zcheng0319-dot/Muscle-Activation-Monitor/website/assets/3030885b3bf76a7612c291005020146e.jpg

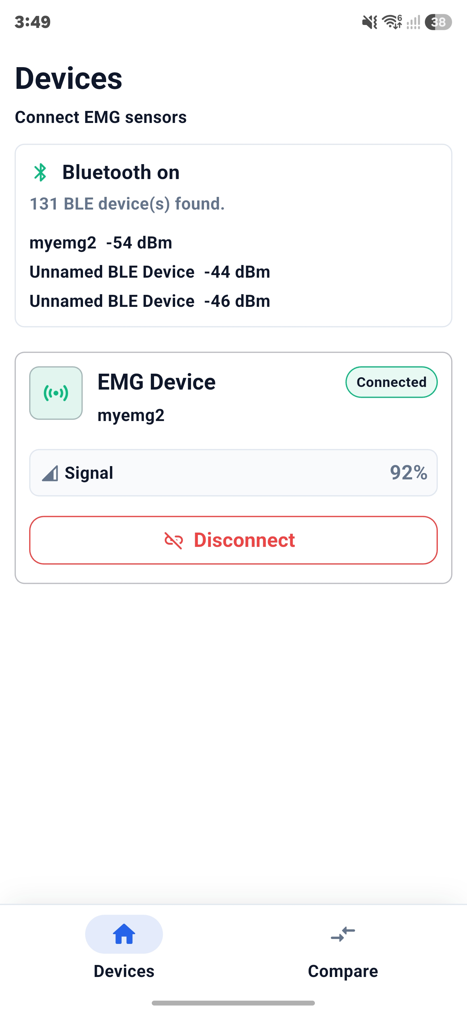
website/assets/3030885b3bf76a7612c291005020146e.jpg
