zcheng0319-dot/Muscle-Activation-Monitor/website/assets/device-1.png

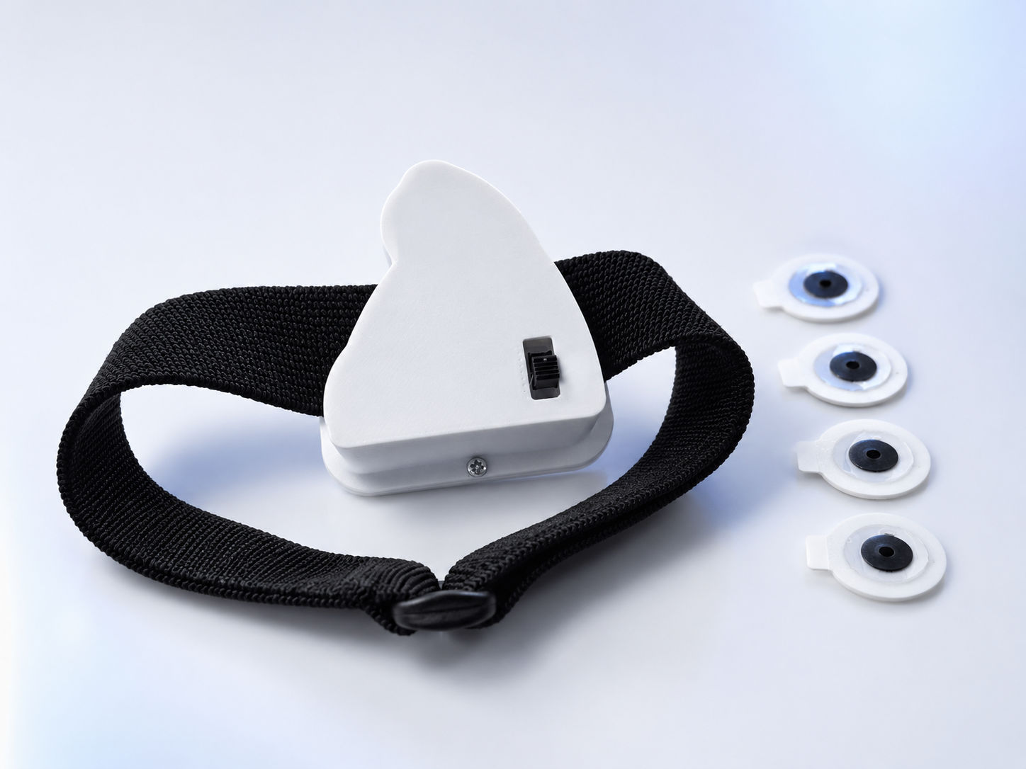
website/assets/device-1.png
