zcheng0319-dot/Muscle-Activation-Monitor/website/assets/device-2.png

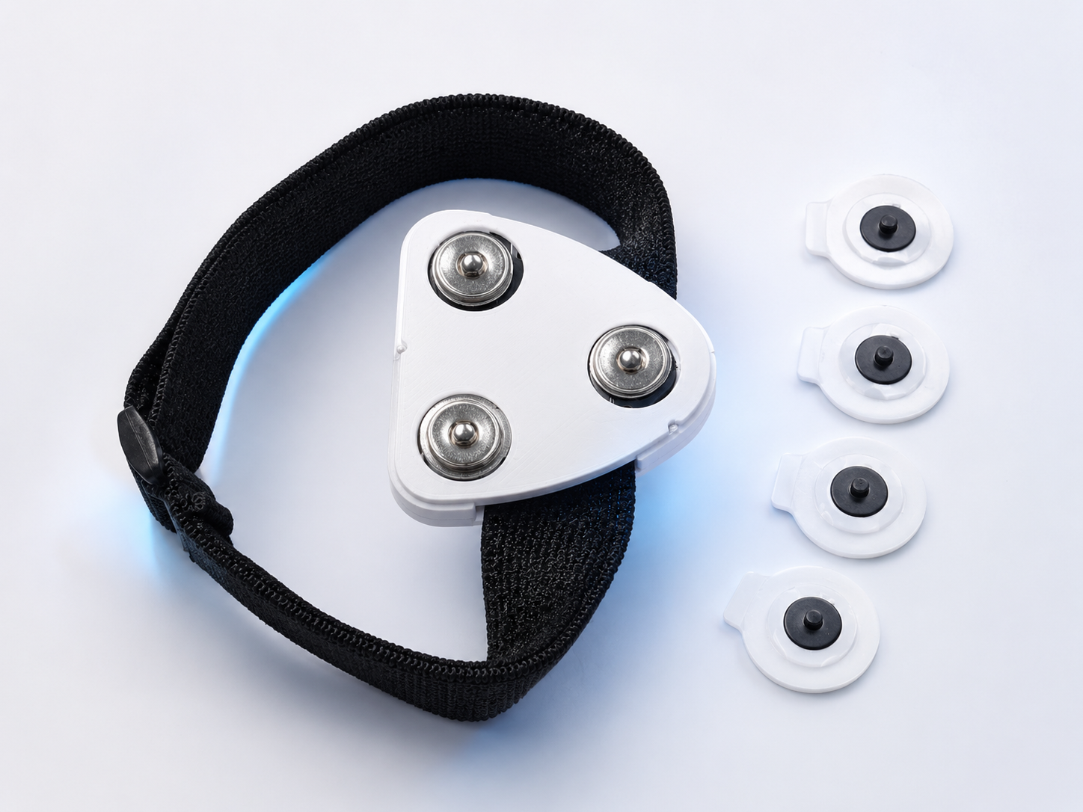
website/assets/device-2.png
