zcheng0319-dot/Muscle-Activation-Monitor/website/assets/myemg-website-qr.png

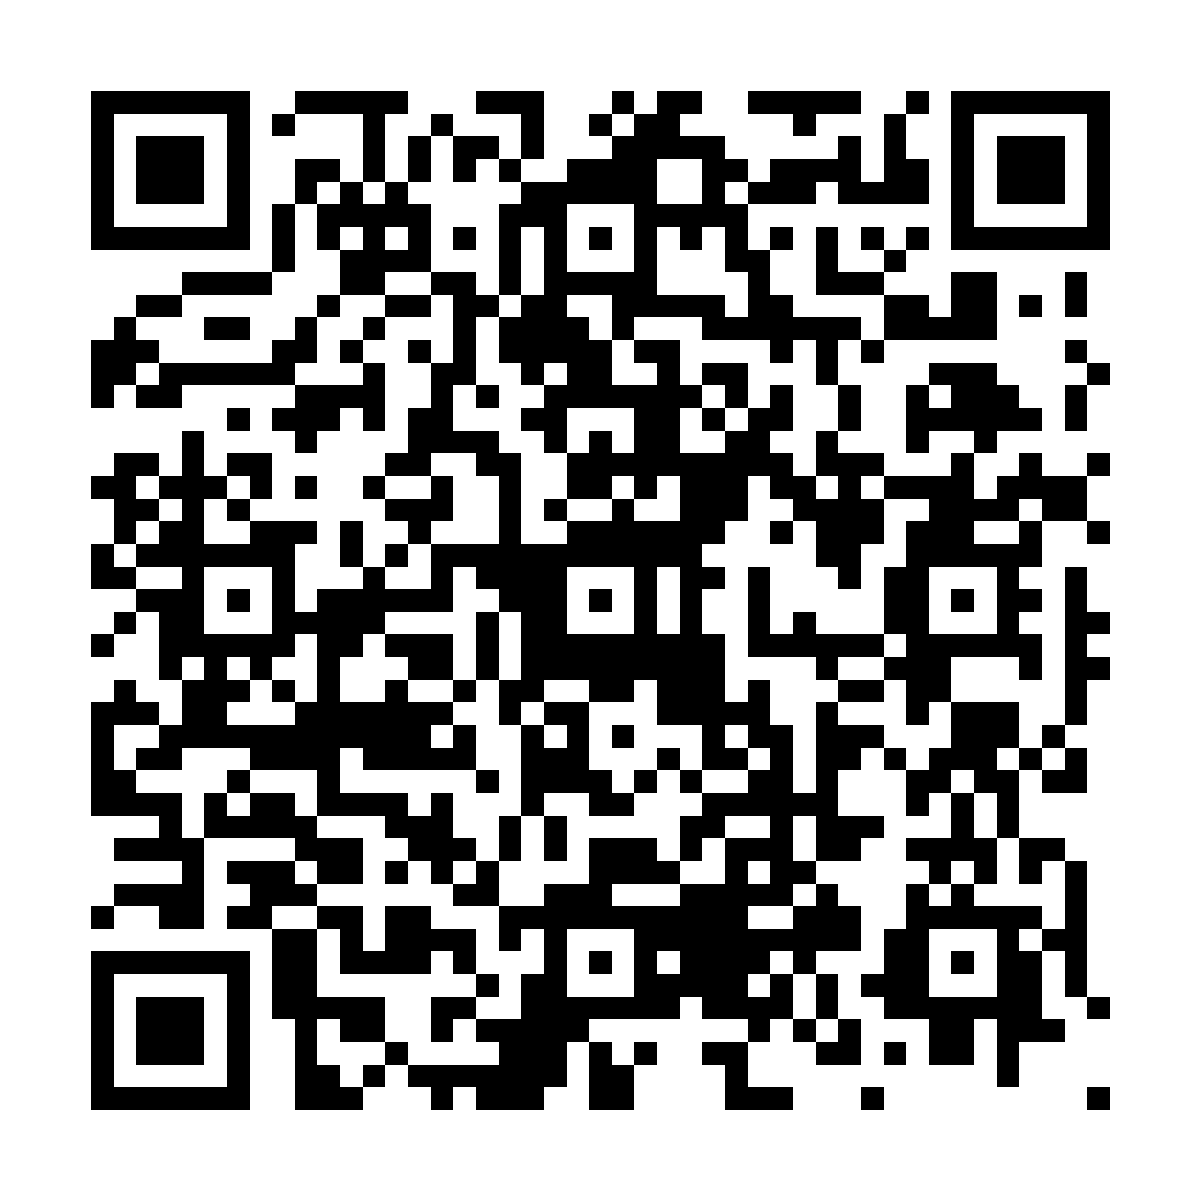
website/assets/myemg-website-qr.png
