zcheng0319-dot/Muscle-Activation-Monitor/hardware/3D-printing/emg-enclosure.step

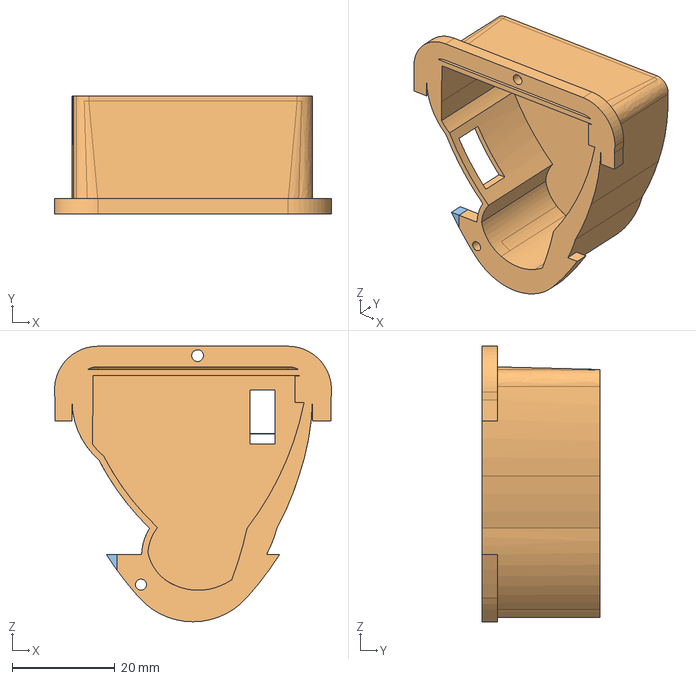
[picture p11: CAD file, 2026-07-08]
hardware/3D-printing/emg-enclosure.step
53.9 x 23.0 x 53.6 mm
