zcheng0319-dot/Muscle-Activation-Monitor/hardware/3D-printing/emg-enclosure .stl.stl

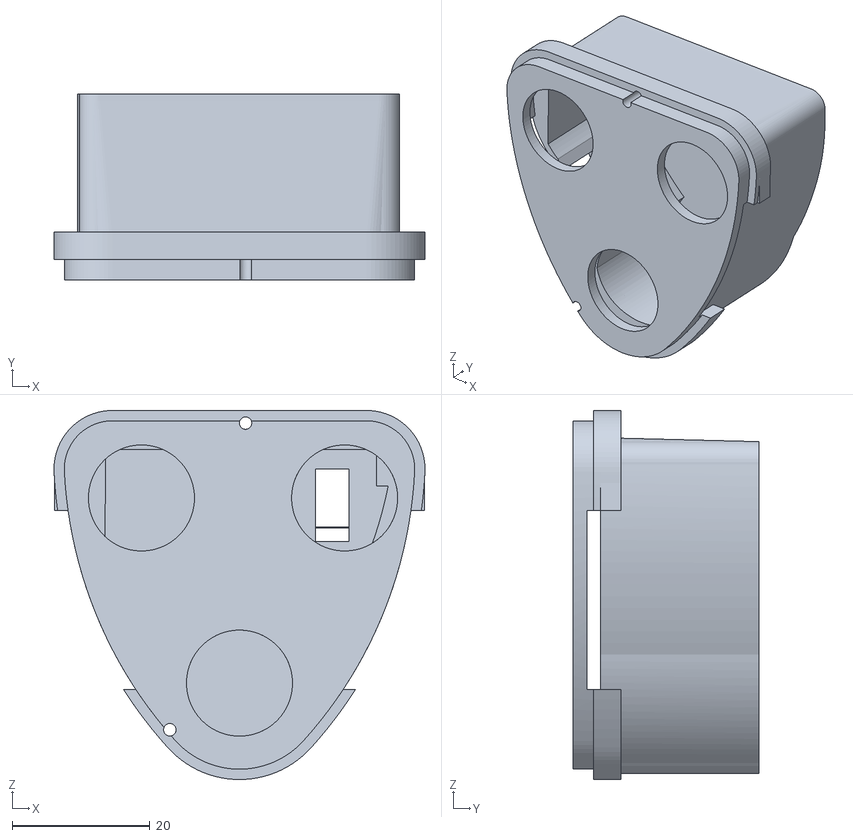
[picture p12: CAD file, 2026-07-08]
hardware/3D-printing/emg-enclosure .stl.stl
53.9 x 27.0 x 53.6
