zcheng0319-dot/Muscle-Activation-Monitor/(commit log)

2026-05-28 feat: add hardware PCB files and EDA project file
2026-06-30 "Update app and Arduino code"
2026-07-01 feat(training): add muscle-based exercise tracking and compact dashboard
    - add Muscle → Exercise selector
    - isolate rankings and sessions by target muscle
    - support muscle and exercise rename/delete
    - filter invalid EMG samples
    - improve session persistence and migration
    - compact Training page layout
2026-07-04 Add unit tests for comparison history and exercise catalog repositories
    - Implement tests for LocalComparisonHistoryRepository to ensure it retains the newest eight completed records, stores summaries without sample arrays, and replaces existing records when saving the same session ID.
    - Create tests for LocalExerciseCatalogRepository to verify that the default catalog is loaded correctly, saved catalogs are restored, and corrupt JSON does not overwrite stored values.
    - Introduce tests for ManageMusclesPage to validate adding, renaming, and deleting muscles and actions, including confirmation prompts for muscle deletion.
    - Add tests for RepSegmenter to confirm correct segmentation of repeate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
    [xiao_esp32c3_emg_ble.ino]
2026-07-05 Add large device images to website assets
2026-07-05 Add device carousel for prototype images with responsive styles
2026-07-08 Refactor code structure for improved readability and maintainability
    [emg-enclosure .stl.stl, emg-enclosure.step]
2026-07-09 Enhance firmware stability: add boot diagnostics, improve BLE restart logic, and manage abnormal reset counts
    [xiao_esp32c3_emg_ble.ino]
2026-07-14 Update assets and improve HTML structure: replace outdated images, add current year dynamically, and enhance CSS styles for better layout
